pydroponics/Hardware/branches/InterruptUARTReceive/Admin Docs/Progress Reports 3-8/Week 4/Stark_Status_4.docx

Engineering Design II
Winter 2013
Weekly Status Report

Account of work completed in previous week and the plan for following week.

Name: Stark Pister

Team: ACAMP

Date: 1/27/13

Week: 4

All Tasks Complete

X Yes

No

Hours spent on project = ~20

High level, overview summary of progress during past week (very concise):

This week I was able to spend more time doing research. We gave the presentation to Oakes and selected a micro and some preliminary parts. Acquired the first Raspberry pi.

Unfinished Tasks:

Completed Tasks:

- Present to C8 College
- Begin ordering parts
- Select microcontroller
- Begin design of solution release system
- Spend more hours researching

To-Do List:

- Spend more hours researching
- Focus research into electronically controlled valves
- Discuss TDS sensors with Petersen
- Select an appropriate TDS sensor that can communicate with the micro
- Systolic pumps research/ Drip feeders?
- Pseudocode

Problems holding up progress:
