pydroponics/Hardware/branches/InterruptUARTReceive/Admin Docs/Budget/Budget.xls

Sheet: Budget
ACAMP Budget
 | Part | Qty | PPU | Total |  | Spending To Date | Budget Remaining | Under: | $299.77
Controller |  |  |  |  |  |  |  | Over: | -$152.65
 | ATmega 2560 | 2 | 20 | $40.00 |  | 0.00 | $40.00 | Under-Over: | $147.12
 | Arduino | 2 | 50 | $100.00 |  | -42.95 | $57.05
 | Raspberry Pi | 2 | 120 | $240.00 |  | -59.95 | $180.05
 | PCB Runs | 2 | 150 | $300.00 |  |  | $300.00
 | Web Hosting | 1 | 50 | $50.00 |  |  | $50.00
Casing |  |  |  |  |  |  | $0.00
 | Enclosure | 1 | 100 | $100.00 |  |  | $100.00
 | Threaded Rods | 6 | 5 | $30.00 |  | -6.90 | $23.10
 | Ducting | 1 | 20 | $20.00 |  |  | $20.00
 | Tubing/Plumbing | 1 | 20 | $20.00 |  | -9.17 | $10.83
 | Plant Tray | 1 | 50 | $50.00 |  | -53.84 | -$3.84
 | Reservoirs | 3 | 20 | $60.00 |  | -16.26 | $43.74
 | Discrete Electronics | 1 | 100 | $100.00 |  | -49.46 | $50.54
 | Assorted Structural Pieces | 1 | 50 | $50.00 |  |  | $50.00
Sensor Systems |  |  |  |  |  |  | $0.00
Plant Height Sensor | Laser Diodes | 2 | 5 | $10.00 |  | -22.95 | -$12.95
 | Receivers | 2 | 5 | $10.00 |  |  | $10.00
Plant Height Actuator | Stepper Motor | 2 | 25 | $50.00 |  | -20.66 | $29.34
 | Controller | 2 | 5 | $10.00 |  |  | $10.00
Temp/Humid Sensor | Temp/Humidity Sensor | 1 | 15 | $15.00 |  | -14.95 | $0.05
Temp/Humid Actuator | Heating Element | 1 | 10 | $10.00 |  |  | $10.00
 | Oscillating Fan | 1 | 15 | $15.00 |  |  | $15.00
 | Exhaust Fan | 1 | 150 | $150.00 |  |  | $150.00
 | Humidifier | 1 | 50 | $50.00 |  |  | $50.00
 | Dehumidifier | 1 | 70 | $70.00 |  |  | $70.00
pH Sensor | pH Sensor | 1 | 120 | $120.00 |  | -105.95 | $14.05
pH Actuator | Servo Motor | 2 | 10 | $20.00 |  | -29.70 | -$9.70
 | pH Solution | 1 | 20 | $20.00 |  |  | $20.00
TDS Sensor | TDS Sensor | 1 | 50 | $50.00 |  | -166.46 | -$116.46
TDS Actuator | Servo Motor | 2 | 10 | $20.00 |  | -29.70 | -$9.70
 | Nutrients | 1 | 40 | $40.00 |  |  | $40.00
Light Sensor | Photosensor | 1 | 5 | $5.00 |  |  | $5.00
Light Actuator | Light Enclosure | 1 | 10 | $10.00 |  |  | $10.00
 | Light Bulb | 2 | 40 | $80.00 |  |  | $80.00
 | Reflective Coating | 1 | 20 | $20.00 |  |  | $20.00
 | Servo Motor | 2 | 20 | $40.00 |  |  | $40.00
Pump System | Ebb/Flow Pump | 1 | 30 | $30.00 |  | -22.14 | $7.86
 | Air Pump | 1 | 10 | $10.00 |  | -9.29 | $0.71
 |  |  |  |  | Categorized Spent | -660.33
 | Subtotal: |  |  | $2015.00 | Total Spent | 660.33
Padding |  | 10% | 0.1 | $201.50
 | Total Budget --- |  |  | $2216.50 | Budget Remaining --- |  | $1556.17
 |  |  | Each: | $554.12

Sheet: Expenditures
Expenditures To Date
Purchases | Components | Amount | Date | Payer | Payer | Total To Date
Rasberry Pi |  | 59.95 | 2013-01-27 | Wayland | Justin | $422.23
 | Raspberry Pi Board | 59.95 |  |  | Wayland | $59.95
 |  |  |  |  | Stark | $166.46
Arduino |  | 42.95 | 2013-01-27 | Justin | Danny | $11.69
 | Arduino Demo Board | 42.95 |  |  | Total: | $660.33
HSC Run |  | 32.97 | 2013-02-09 | Justin
 | Stepper Motor x2 | 20.66
 | DVI to HDMI cable | 4.89
 | BNC x2 | 4.24
 | Switch | 0.51
 | 10k Pot | 2.12
 | Knob | 0.54
Santa Cruz Hydroponics |  | 100.08 | 2013-02-09 | Justin
 | Air Pump | 9.29
 | Water Pump | 22.14
 | Power Cord | 5.64
 | 4 Feet Clear Tubing | 0.48
 | 4 Feet Black Hose | 1.13
 | Ebb and Flow Tray | 53.84
 | Screen Fitting | 0.64
 | Tub Outlet Fitting x2 | 4.70
 | Outlet Extension x3 | 2.22
Home Depot |  | 23.16 | 2013-02-09 | Justin
 | Threaded Rods | 6.90
 | Reservoir | 16.26
Radioshack |  | 11.69 | 2013-02-10 | Danny
 | 12V Regulator | 1.95
 | Diode | 3.41
 | PNP Transistors x15 | 3.41
 | NPN transistors x2 | 2.91
Ace Hardware |  | 19.81 | 2013-02-10 | Justin
 | Male Wall Connector | 7.06
 | Female Wall Connector | 7.60
 | Lamp Wire | 5.15
Sensors (Temp/Humidity, pH) |  | 120.90 | 2013-02-18 | Justin
 | Temp/Humidity Sensor | 14.95
 | pH Sensor | 105.95
Actuator Valves |  | 59.40 | 2013-02-23 | Justin
 | Solenoid Valve x4 | 59.40
Line Laser Module |  | 22.95 | 2013-02-16 | Justin
 | 1mW Line Laser | 22.95
Conductivity Sensor |  | 166.46 | 2013-02-28 | Stark
 | Conductivity Sensor | 166.46
