pydroponics/Hardware/branches/InterruptUARTReceive/Admin Docs/Winter Report/Winter Report Assembly/Outline.docx

ACAMP

Final Report Outline

# I. Introduction

## A. Introduce Team

### 1. Stark and Wayland (CE), Danny and Justin (EE)

## B. Purpose

### 1. Why hydroponics (explanation of water use)

### 2. Why automation is important

## C. Visual Overview

### 1. Probably different views of our Solidworks drawings

# II. Research completed

## A. Hydroponics

## B. Sensors

## C. Actuators

# III. Design

## A. Key features

### 1. Structure and physical design

### 2. Light and water/air pump cycles automated

### 3. Temperature/humidity sensors and controls

### 4. Solenoid valve automation for pH and nutrient release

### 5. Plant height measurement using webcam & light height adjustment

### 6. Web monitoring and control

## B. Components

### 1. Physical

#### a) Which parts we’ve used

#### b) Which parts we intend on using

#### c) Components we haven’t decided on yet

#### d) Why we picked these parts

### 2. Sensors

#### a) Which parts we’ve used

#### b) Which parts we intend on using

#### c) Components we haven’t decided on yet

#### d) Why we picked these parts

### 3. Actuators

#### a) Which parts we’ve used

#### b) Which parts we intend on using

#### c) Components we haven’t decided on yet

#### d) Why we picked these parts

## C. Block Diagrams

### 1. Top level block diagram

### 2. Subsystem block diagram

## D. Software

### 1. Flow chart for overall system

### 2. Flow chart for each subsystem

## E. Division of Labor

### 1. Going to list who has done what so far and what they plan to do next quarter

# IV. Goals from Winter Quarter

## A. Visual of Gantt Chart for this quarter

# V. Tests conducted

## A. Videos

### 1. Water/air pump automation

### 2. pH in water tests

### 3. Temperature/humidity sensors

## B. Details of how we tested our sensors

### 1. Water pump – discuss how we used our timers

### 2. pH – discuss how we altered the pH of the water and observed the change

### 3. Temp/Hum – talk about use of Raspberry Pi and how the sensor measures the environment

# VI. Progress

## A. Gantt Chart

## B. Which goals we’ve finished

### 1. pH, TDS, and Temp/Humidity sensors

### 2. Water/air pump

### 3. Physical structure

### 4. Atmega2560/Raspberry Pi integration

## C. Which goals we’re currently working on

### 1. Solenoid release valves

### 2. Power supply setup

## D. Completion Percentage

## E. Budget Progress

### 1. Expenditures so far

### 2. Expenditures remaining

### 3. Revised estimated cost

# VII. Accomplishments

## A. Milestones from Gantt

### 1. Designs completed

### 2. Sensors completed

### 3. Actuators completed

## B. Things we are proud of

### 1. First time pumps worked

### 2. Serial communication

### 3. Completion of sensors

### 4. Getting DHT22 to work despite difficulties

# VIII. Problems

## A. Plant height detection system

### 1. Laser system wasn’t going to work with the time allotted

### 2. Switched to webcam

### 3. Need to figure out image processing

## B. Others?

# IX. Conclusion

## A. Plan for next quarter

### 1. Individualized plans for next quarter

### 2. Things we’d like to add if time permits
