pydroponics/Hardware/branches/InterruptUARTReceive/Admin Docs/Gantt/Minimum Spec Tests.xls

System | Test | Success Criterion
Light Control Systems
Bulb Height | 1. Place object (potted plant) on grow tray | Light bulb is raised
 | 2. Remove object from enclosure | Light bulb is lowered
Cycling Interface | 3. Toggle light power to simulate growth cycle using microcontroller | Light turns on and off
Water Control Systems
Reservoir Pump | 4. Turn on pump using microcontroller to fill flood tray | Flood tray fills within 5 minutes
 | 5. Turn off pump to allow drainage | Flood tray drains
pH Sensor/Pump | 6. Add pH Up solution manually to reservoir | pH Down pump turns on
 | 7. Add pH Down solution manually to reservoir | pH Up pump turns on
TDS Sensor/ Nutrient Pump | 8. Add nutrients manually to reservoir | Water pump turns on
 | 9. Add water manually to reservoir | Nutrient pump turns on
Water Temp Control | 10. Add ice cubes to the reservoir | Water heater turns on
Environment Control Systems
Air Cooling | 11. Use space heater to warm air within the enclosure | Exhaust fan turns on
Dehumidifier | 12. Mist the enclosure with water | Dehumidifier turns on
Web-RPi-ATmega Interfacing
Web Interface | 13. Use web interface to virtually repeat tests 1-12 | See tests 1-12
